napolanocarmine/home-security-system/ConnectionScheme.jpg

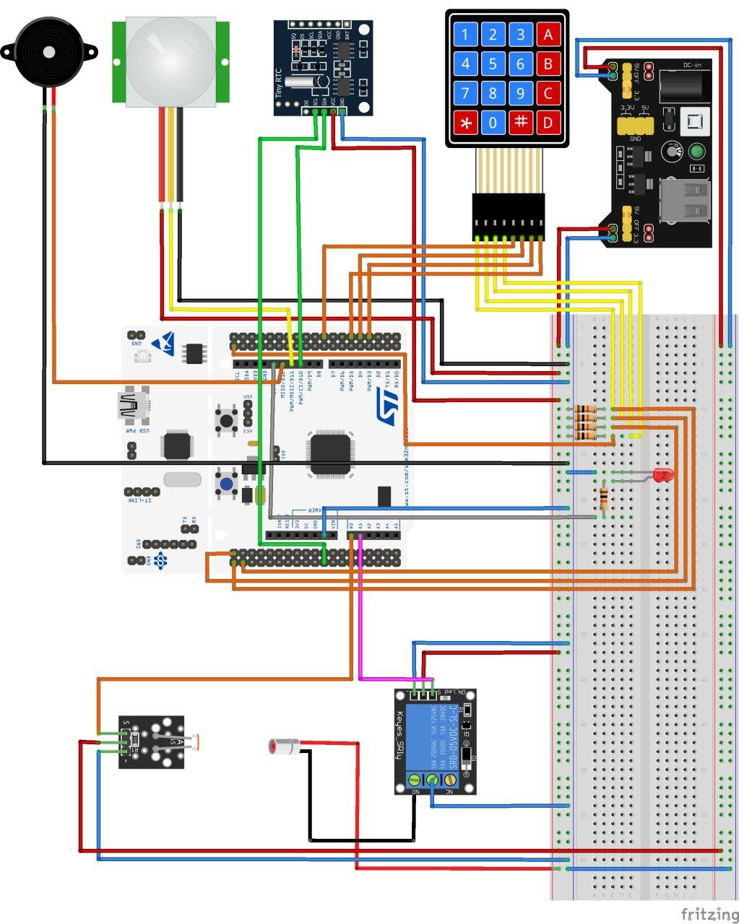
ConnectionScheme.jpg
