napolanocarmine/home-security-system/Home_Security_System/Core/Src/main.c

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

/* Includes ------------------------------------------------------------------*/
#include "main.h"
#include "adc.h"
#include "dma.h"
#include "i2c.h"
#include "tim.h"
#include "usart.h"
#include "gpio.h"

/* USER CODE BEGIN Includes */
#include "system.h"
#include "ds1307rtc.h"
#include "uart_handler.h"
#include "system_log.h"
#include "system_led.h"
#include "string.h"
#include "stdio.h"
/* USER CODE END Includes */

/* USER CODE BEGIN PD */
/**
 * @brief waiting time for user inserting START
 */
#define WAITING_TIME (30000)
/**
 * @brief buffer size for waiting procedure
 */
#define BUFFER_WAITING_SIZE (6)

#define START_STRING ("START")
/* USER CODE END PD */


void SystemClock_Config(void);
/* USER CODE BEGIN PFP */
int8_t check_putty();
/* USER CODE END PFP */

/**
  * @brief  The application entry point.
  * @retval int
  */
int main(void)
{
  /* MCU Configuration--------------------------------------------------------*/

  /* Reset of all peripherals, Initializes the Flash interface and the Systick. */
  HAL_Init();

  /* Configure the system clock */
  SystemClock_Config();

  /* Initialize all configured peripherals */
  MX_GPIO_Init();
  MX_DMA_Init();
  MX_TIM10_Init();
  MX_USART2_UART_Init();
  MX_ADC1_Init();
  MX_I2C1_Init();
  MX_TIM3_Init();
  MX_TIM11_Init();
  MX_TIM1_Init();
  MX_TIM2_Init();
  /* USER CODE BEGIN 2 */
  //init_system(SYSTEM_ACTIVE);
  /* USER CODE END 2 */

  /* Infinite loop */
  /* USER CODE BEGIN WHILE */

  while(check_putty() != 0){}

  if(init_system() == SYS_OK)
	  run_system();


  while (1)
  {
    /* USER CODE END WHILE */

    /* USER CODE BEGIN 3 */
  }
  /* USER CODE END 3 */
}

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
/* USER CODE BEGIN 4 */
/**
 * @brief wait for user, that must insert START before the system boots.
 * @retval operation result, 0 if START has been inserted or -1 if not
 */
int8_t check_putty(){

	uint8_t buffer[BUFFER_WAITING_SIZE];
	sprintf((char *)buffer,"\n\r");
	HAL_UART_Transmit(&huart2, buffer, strlen((char *)buffer), HAL_MAX_DELAY);
	HAL_StatusTypeDef retr_val = HAL_UART_Receive(&huart2, buffer, strlen(START_STRING), WAITING_TIME); // wait 30 seconds for START
	if(retr_val == HAL_OK && strcmp(START_STRING, (char *)buffer) == 0){
		HAL_UART_Transmit(&huart2, buffer, strlen((char *)buffer), HAL_MAX_DELAY); // send back the inserted START string
		return 0;
	}else{
		sprintf((char*)buffer, "ERROR");
		HAL_UART_Transmit(&huart2, buffer, strlen((char *)buffer), HAL_MAX_DELAY); // send error string
	}
		return -1;

}
/* USER CODE END 4 */
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
