napolanocarmine/home-security-system/Home_Security_System/Home_Security_System.ioc

Mcu.UserName=STM32F401RETx
PA0-WKUP.Signal=ADCx_IN0
PA1.Signal=GPIO_Output
PA2.Signal=USART2_TX
PA3.Signal=USART2_RX
PA5.Signal=GPIO_Output
PA6.Signal=S_TIM3_CH1
PA7.Signal=GPXTI7
PB2.Signal=GPIO_Output
PB3.Signal=GPIO_Output
PB4.Signal=GPIO_Output
PB5.Signal=GPIO_Output
PB6.Signal=I2C1_SCL
PB7.Signal=I2C1_SDA
PC10.Signal=GPXTI10
PC11.Signal=GPXTI11
PC12.Signal=GPXTI12
PC13-ANTI_TAMP.Signal=GPXTI13
PC14-OSC32_IN.Signal=GPXTI14
PC9.Signal=GPXTI9
