napolanocarmine/home-security-system/Home_Security_System/Core/Src/tim.c

/**
  ******************************************************************************
  * File Name          : TIM.c
  * Description        : This file provides code for the configuration
  *                      of the TIM instances.
  ******************************************************************************
  * @attention
  *
  * <h2><center>&copy; Copyright (c) 2020 STMicroelectronics.
  * All rights reserved.</center></h2>
  *
  * This software component is licensed by ST under BSD 3-Clause license,
  * the "License"; You may not use this file except in compliance with the
  * License. You may obtain a copy of the License at:
  *                        opensource.org/licenses/BSD-3-Clause
  *
  ******************************************************************************
  */

/* Includes ------------------------------------------------------------------*/
#include "tim.h"

TIM_HandleTypeDef htim1;
TIM_HandleTypeDef htim2;
TIM_HandleTypeDef htim3;
TIM_HandleTypeDef htim10;
TIM_HandleTypeDef htim11;

/* TIM1 init function */
void MX_TIM1_Init(void)
{
  TIM_ClockConfigTypeDef sClockSourceConfig = {0};
  TIM_MasterConfigTypeDef sMasterConfig = {0};

  htim1.Instance = TIM1;
  htim1.Init.Prescaler = 15999;
  htim1.Init.CounterMode = TIM_COUNTERMODE_UP;
  htim1.Init.Period = 999;
  htim1.Init.ClockDivision = TIM_CLOCKDIVISION_DIV1;
  htim1.Init.RepetitionCounter = 0;
  htim1.Init.AutoReloadPreload = TIM_AUTORELOAD_PRELOAD_DISABLE;
  if (HAL_TIM_Base_Init(&htim1) != HAL_OK)
  {
    Error_Handler();
  }
  sClockSourceConfig.ClockSource = TIM_CLOCKSOURCE_INTERNAL;
  if (HAL_TIM_ConfigClockSource(&htim1, &sClockSourceConfig) != HAL_OK)
  {
    Error_Handler();
  }
  sMasterConfig.MasterOutputTrigger = TIM_TRGO_RESET;
  sMasterConfig.MasterSlaveMode = TIM_MASTERSLAVEMODE_DISABLE;
  if (HAL_TIMEx_MasterConfigSynchronization(&htim1, &sMasterConfig) != HAL_OK)
  {
    Error_Handler();
  }

  /* TIM1 interrupt Init */
  HAL_NVIC_SetPriority(TIM1_UP_TIM10_IRQn, 0, 0);
  HAL_NVIC_EnableIRQ(TIM1_UP_TIM10_IRQn);
  HAL_NVIC_SetPriority(TIM1_TRG_COM_TIM11_IRQn, 0, 0);
  HAL_NVIC_EnableIRQ(TIM1_TRG_COM_TIM11_IRQn);
  /* USER CODE BEGIN TIM1_MspInit 1 */
  __HAL_TIM_CLEAR_IT(&htim1, TIM1_UP_TIM10_IRQn);
  __HAL_TIM_CLEAR_IT(&htim1, TIM1_TRG_COM_TIM11_IRQn);
  /* USER CODE END TIM1_MspInit 1 */

}
/* TIM2 init function */
void MX_TIM2_Init(void)
{
  TIM_ClockConfigTypeDef sClockSourceConfig = {0};
  TIM_MasterConfigTypeDef sMasterConfig = {0};

  htim2.Instance = TIM2;
  htim2.Init.Prescaler = 15999;
  htim2.Init.CounterMode = TIM_COUNTERMODE_UP;
  htim2.Init.Period = 999;
  htim2.Init.ClockDivision = TIM_CLOCKDIVISION_DIV1;
  htim2.Init.AutoReloadPreload = TIM_AUTORELOAD_PRELOAD_DISABLE;
  if (HAL_TIM_Base_Init(&htim2) != HAL_OK)
  {
    Error_Handler();
  }
  sClockSourceConfig.ClockSource = TIM_CLOCKSOURCE_INTERNAL;
  if (HAL_TIM_ConfigClockSource(&htim2, &sClockSourceConfig) != HAL_OK)
  {
    Error_Handler();
  }
  sMasterConfig.MasterOutputTrigger = TIM_TRGO_RESET;
  sMasterConfig.MasterSlaveMode = TIM_MASTERSLAVEMODE_DISABLE;
  if (HAL_TIMEx_MasterConfigSynchronization(&htim2, &sMasterConfig) != HAL_OK)
  {
    Error_Handler();
  }

  /* TIM2 interrupt Init */
  HAL_NVIC_SetPriority(TIM2_IRQn, 0, 0);
  HAL_NVIC_EnableIRQ(TIM2_IRQn);
  /* USER CODE BEGIN TIM2_MspInit 1 */
  __HAL_TIM_CLEAR_IT(&htim2, TIM2_IRQn);
  /* USER CODE END TIM2_MspInit 1 */


}
/* TIM3 init function */
void MX_TIM3_Init(void)
{
  TIM_ClockConfigTypeDef sClockSourceConfig = {0};
  TIM_MasterConfigTypeDef sMasterConfig = {0};
  TIM_OC_InitTypeDef sConfigOC = {0};

  htim3.Instance = TIM3;
  htim3.Init.Prescaler = 15999;
  htim3.Init.CounterMode = TIM_COUNTERMODE_UP;
  htim3.Init.Period = 999;
  htim3.Init.ClockDivision = TIM_CLOCKDIVISION_DIV1;
  htim3.Init.AutoReloadPreload = TIM_AUTORELOAD_PRELOAD_DISABLE;
  if (HAL_TIM_Base_Init(&htim3) != HAL_OK)
  {
    Error_Handler();
  }
  sClockSourceConfig.ClockSource = TIM_CLOCKSOURCE_INTERNAL;
  if (HAL_TIM_ConfigClockSource(&htim3, &sClockSourceConfig) != HAL_OK)
  {
    Error_Handler();
  }
  if (HAL_TIM_PWM_Init(&htim3) != HAL_OK)
  {
    Error_Handler();
  }
  sMasterConfig.MasterOutputTrigger = TIM_TRGO_RESET;
  sMasterConfig.MasterSlaveMode = TIM_MASTERSLAVEMODE_DISABLE;
  if (HAL_TIMEx_MasterConfigSynchronization(&htim3, &sMasterConfig) != HAL_OK)
  {
    Error_Handler();
  }
  sConfigOC.OCMode = TIM_OCMODE_PWM1;
  sConfigOC.Pulse = 0;
  sConfigOC.OCPolarity = TIM_OCPOLARITY_HIGH;
  sConfigOC.OCFastMode = TIM_OCFAST_DISABLE;
  if (HAL_TIM_PWM_ConfigChannel(&htim3, &sConfigOC, TIM_CHANNEL_1) != HAL_OK)
  {
    Error_Handler();
  }
  __HAL_TIM_DISABLE_OCxPRELOAD(&htim3, TIM_CHANNEL_1);
  HAL_TIM_MspPostInit(&htim3);

  /* TIM3 interrupt Init */
  HAL_NVIC_SetPriority(TIM3_IRQn, 0, 0);
  HAL_NVIC_EnableIRQ(TIM3_IRQn);
  /* USER CODE BEGIN TIM3_MspInit 1 */
  __HAL_TIM_CLEAR_IT(&htim3, TIM3_IRQn);
  /* USER CODE END TIM3_MspInit 1 */

}
/* TIM10 init function */
void MX_TIM10_Init(void)
{

  htim10.Instance = TIM10;
  htim10.Init.Prescaler = 15999;
  htim10.Init.CounterMode = TIM_COUNTERMODE_UP;
  htim10.Init.Period = 0;
  htim10.Init.ClockDivision = TIM_CLOCKDIVISION_DIV1;
  htim10.Init.AutoReloadPreload = TIM_AUTORELOAD_PRELOAD_DISABLE;
  if (HAL_TIM_Base_Init(&htim10) != HAL_OK)
  {
    Error_Handler();
  }

  /* TIM10 interrupt Init */
  HAL_NVIC_SetPriority(TIM1_UP_TIM10_IRQn, 0, 0);
  HAL_NVIC_EnableIRQ(TIM1_UP_TIM10_IRQn);
 /* USER CODE BEGIN TIM10_MspInit 1 */
  __HAL_TIM_CLEAR_IT(&htim10, TIM1_UP_TIM10_IRQn);
  /* USER CODE END TIM10_MspInit 1 */

}
/* TIM11 init function */
void MX_TIM11_Init(void)
{

  htim11.Instance = TIM11;
  htim11.Init.Prescaler = 15999;
  htim11.Init.CounterMode = TIM_COUNTERMODE_UP;
  htim11.Init.Period = 0;
  htim11.Init.ClockDivision = TIM_CLOCKDIVISION_DIV1;
  htim11.Init.AutoReloadPreload = TIM_AUTORELOAD_PRELOAD_DISABLE;
  if (HAL_TIM_Base_Init(&htim11) != HAL_OK)
  {
    Error_Handler();
  }

  /* TIM11 interrupt Init */
  HAL_NVIC_SetPriority(TIM1_TRG_COM_TIM11_IRQn, 0, 0);
  HAL_NVIC_EnableIRQ(TIM1_TRG_COM_TIM11_IRQn);
  /* USER CODE BEGIN TIM11_MspInit 1 */
  __HAL_TIM_CLEAR_IT(&htim11, TIM1_TRG_COM_TIM11_IRQn);

}

void HAL_TIM_Base_MspInit(TIM_HandleTypeDef* tim_baseHandle)
{

  if(tim_baseHandle->Instance==TIM1)
  {
    /* TIM1 clock enable */
    __HAL_RCC_TIM1_CLK_ENABLE();


  }
  else if(tim_baseHandle->Instance==TIM2)
  {
    /* TIM2 clock enable */
    __HAL_RCC_TIM2_CLK_ENABLE();


  }
  else if(tim_baseHandle->Instance==TIM3)
  {
    /* TIM3 clock enable */
    __HAL_RCC_TIM3_CLK_ENABLE();


  }
  else if(tim_baseHandle->Instance==TIM10)
  {
    /* TIM10 clock enable */
    __HAL_RCC_TIM10_CLK_ENABLE();


  }
  else if(tim_baseHandle->Instance==TIM11)
  {
    /* TIM11 clock enable */
    __HAL_RCC_TIM11_CLK_ENABLE();

  }
}
void HAL_TIM_MspPostInit(TIM_HandleTypeDef* timHandle)
{

  GPIO_InitTypeDef GPIO_InitStruct = {0};
  if(timHandle->Instance==TIM3)
  {
  
    __HAL_RCC_GPIOA_CLK_ENABLE();
    /**TIM3 GPIO Configuration    
    PA6     ------> TIM3_CH1 
    */
    GPIO_InitStruct.Pin = GPIO_PIN_6;
    GPIO_InitStruct.Mode = GPIO_MODE_AF_PP;
    GPIO_InitStruct.Pull = GPIO_NOPULL;
    GPIO_InitStruct.Speed = GPIO_SPEED_FREQ_LOW;
    GPIO_InitStruct.Alternate = GPIO_AF2_TIM3;
    HAL_GPIO_Init(GPIOA, &GPIO_InitStruct);

  }

}

void HAL_TIM_Base_MspDeInit(TIM_HandleTypeDef* tim_baseHandle)
{

  if(tim_baseHandle->Instance==TIM1)
  {
    /* Peripheral clock disable */
    __HAL_RCC_TIM1_CLK_DISABLE();

    /* TIM1 interrupt Deinit */
  /* USER CODE BEGIN TIM1:TIM1_UP_TIM10_IRQn disable */
    /**
    * Uncomment the line below to disable the "TIM1_UP_TIM10_IRQn" interrupt
    * Be aware, disabling shared interrupt may affect other IPs
    */
    /* HAL_NVIC_DisableIRQ(TIM1_UP_TIM10_IRQn); */
  /* USER CODE END TIM1:TIM1_UP_TIM10_IRQn disable */

  /* USER CODE BEGIN TIM1:TIM1_TRG_COM_TIM11_IRQn disable */
    /**
    * Uncomment the line below to disable the "TIM1_TRG_COM_TIM11_IRQn" interrupt
    * Be aware, disabling shared interrupt may affect other IPs
    */
    /* HAL_NVIC_DisableIRQ(TIM1_TRG_COM_TIM11_IRQn); */
  /* USER CODE END TIM1:TIM1_TRG_COM_TIM11_IRQn disable */

  }
  else if(tim_baseHandle->Instance==TIM2)
  {
    /* Peripheral clock disable */
    __HAL_RCC_TIM2_CLK_DISABLE();

    /* TIM2 interrupt Deinit */
    HAL_NVIC_DisableIRQ(TIM2_IRQn);
  }
  else if(tim_baseHandle->Instance==TIM3)
  {
    /* Peripheral clock disable */
    __HAL_RCC_TIM3_CLK_DISABLE();

    /* TIM3 interrupt Deinit */
    HAL_NVIC_DisableIRQ(TIM3_IRQn);
  }
  else if(tim_baseHandle->Instance==TIM10)
  {
    /* Peripheral clock disable */
    __HAL_RCC_TIM10_CLK_DISABLE();

    /* TIM10 interrupt Deinit */
  /* USER CODE BEGIN TIM10:TIM1_UP_TIM10_IRQn disable */
    /**
    * Uncomment the line below to disable the "TIM1_UP_TIM10_IRQn" interrupt
    * Be aware, disabling shared interrupt may affect other IPs
    */
    /* HAL_NVIC_DisableIRQ(TIM1_UP_TIM10_IRQn); */
  /* USER CODE END TIM10:TIM1_UP_TIM10_IRQn disable */

  }
  else if(tim_baseHandle->Instance==TIM11)
  {
    /* Peripheral clock disable */
    __HAL_RCC_TIM11_CLK_DISABLE();

    /* TIM11 interrupt Deinit */
  /* USER CODE BEGIN TIM11:TIM1_TRG_COM_TIM11_IRQn disable */
    /**
    * Uncomment the line below to disable the "TIM1_TRG_COM_TIM11_IRQn" interrupt
    * Be aware, disabling shared interrupt may affect other IPs
    */
    /* HAL_NVIC_DisableIRQ(TIM1_TRG_COM_TIM11_IRQn); */
  /* USER CODE END TIM11:TIM1_TRG_COM_TIM11_IRQn disable */

  }
} 

/************************ (C) COPYRIGHT STMicroelectronics *****END OF FILE****/
